HE-Arc/thereduino/readme.md

## Theremin arduino

thereduino

Ce montage permet d'imiter grossièremeent le fonctionnement d'un [theremin](https://en.wikipedia.org/wiki/Theremin). 

Il est constitué de 2 capteurs de lumière ambiante, permettant, selon la quantité de lumière reçue :
* de couper le son
* de changer la fréquence (hauteur) du son

L'utilisateur peut moduler la lumière en masquant les capteurs de lumières avec ses mains.

## Atelier 

Ce projet est conçu pour être monté et pris en main par des enfants à partir de 10 ans dans le cadre d'un atelier.

L'atelier se déroule en 2 phases :

1. Soudage de la carte de contrôle et des composants 
2. Présentation et modification du logiciel pour en  personnaliser le fonctionnement.

## Code 

Dans /src :

* *theremin* : projet Arduino permettant d'emettre des sons selon la lumière captée
* *testHW* : projet Arduino qui permet de tester le montage électronique

## Licence

<br />Cette œuvre est mise à disposition selon les termes de la <a rel="license" href="http://creativecommons.org/licenses/by/4.0/">Licence Creative Commons Attribution 4.0 International</a>.

## En savoir plus sur le theremin
* [Grégoire Blanc présente son instrument](https://www.youtube.com/watch?v=Q9dIHBrgzjg) et passe à la [télé](https://www.youtube.com/watch?v=r6s36h1tEN4)
* [Sheldon joue le générique de Star Trek](https://www.youtube.com/watch?v=_YYABE0R3uA)
* [Carolina Eyck présente son instrument](https://www.youtube.com/watch?v=Xh_oWPtC-Kk)
* [Coralie Ehinger](https://www.youtube.com/watch?v=oBOYVRlQG_o)
* [Chanson connues avec du theremin](https://www.songfacts.com/category/songs-that-use-a-theremin)
* [Présentation par son inventeur (1954)](https://www.youtube.com/watch?v=_3H5JbkPXpw)

## Crédits

Ont participé au développement du projet : Manon Racine, Gérald Huguenin, David Grunenwald
Avec les moyens mis à disposition par la [HE-Arc Ingénierie](http://www.he-arc.ch/ingenierie)
