HE-Arc/thereduino/doc/intro.pptx

Atelier Theremine
Bienvenue !

## Slide 2

Atelier Theremine

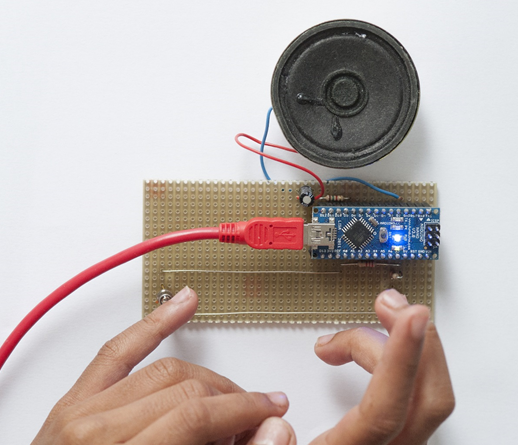
[picture p1: figure]

## Slide 3

Atelier Theremine

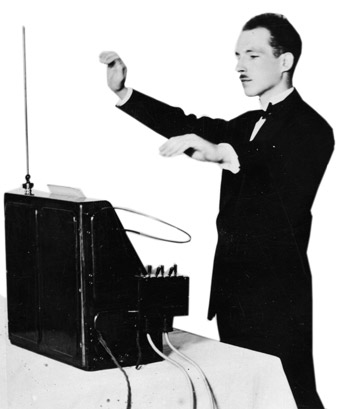
[picture p2: figure]

Version originale : antennes
Version optique

## Slide 4

Atelier Theremine

2 étapes :
  - Montage (soudure)
  - Programmation

## Slide 5

Atelier Theremine

Soudure :

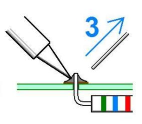
[picture p3: figure]
