HE-Arc/thereduino/(commit log)

2016-12-21 workaround to fix issue #1
    [theremin.ino]
2017-01-16 Updated guide, updated readme and added dccunino nano drivers
